AlierenSafi/Aquarium-Controller/images/List.PNG

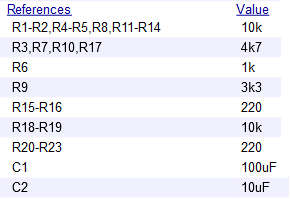
images/List.PNG
