AlierenSafi/Aquarium-Controller/Aquarium_Scheme.PDF

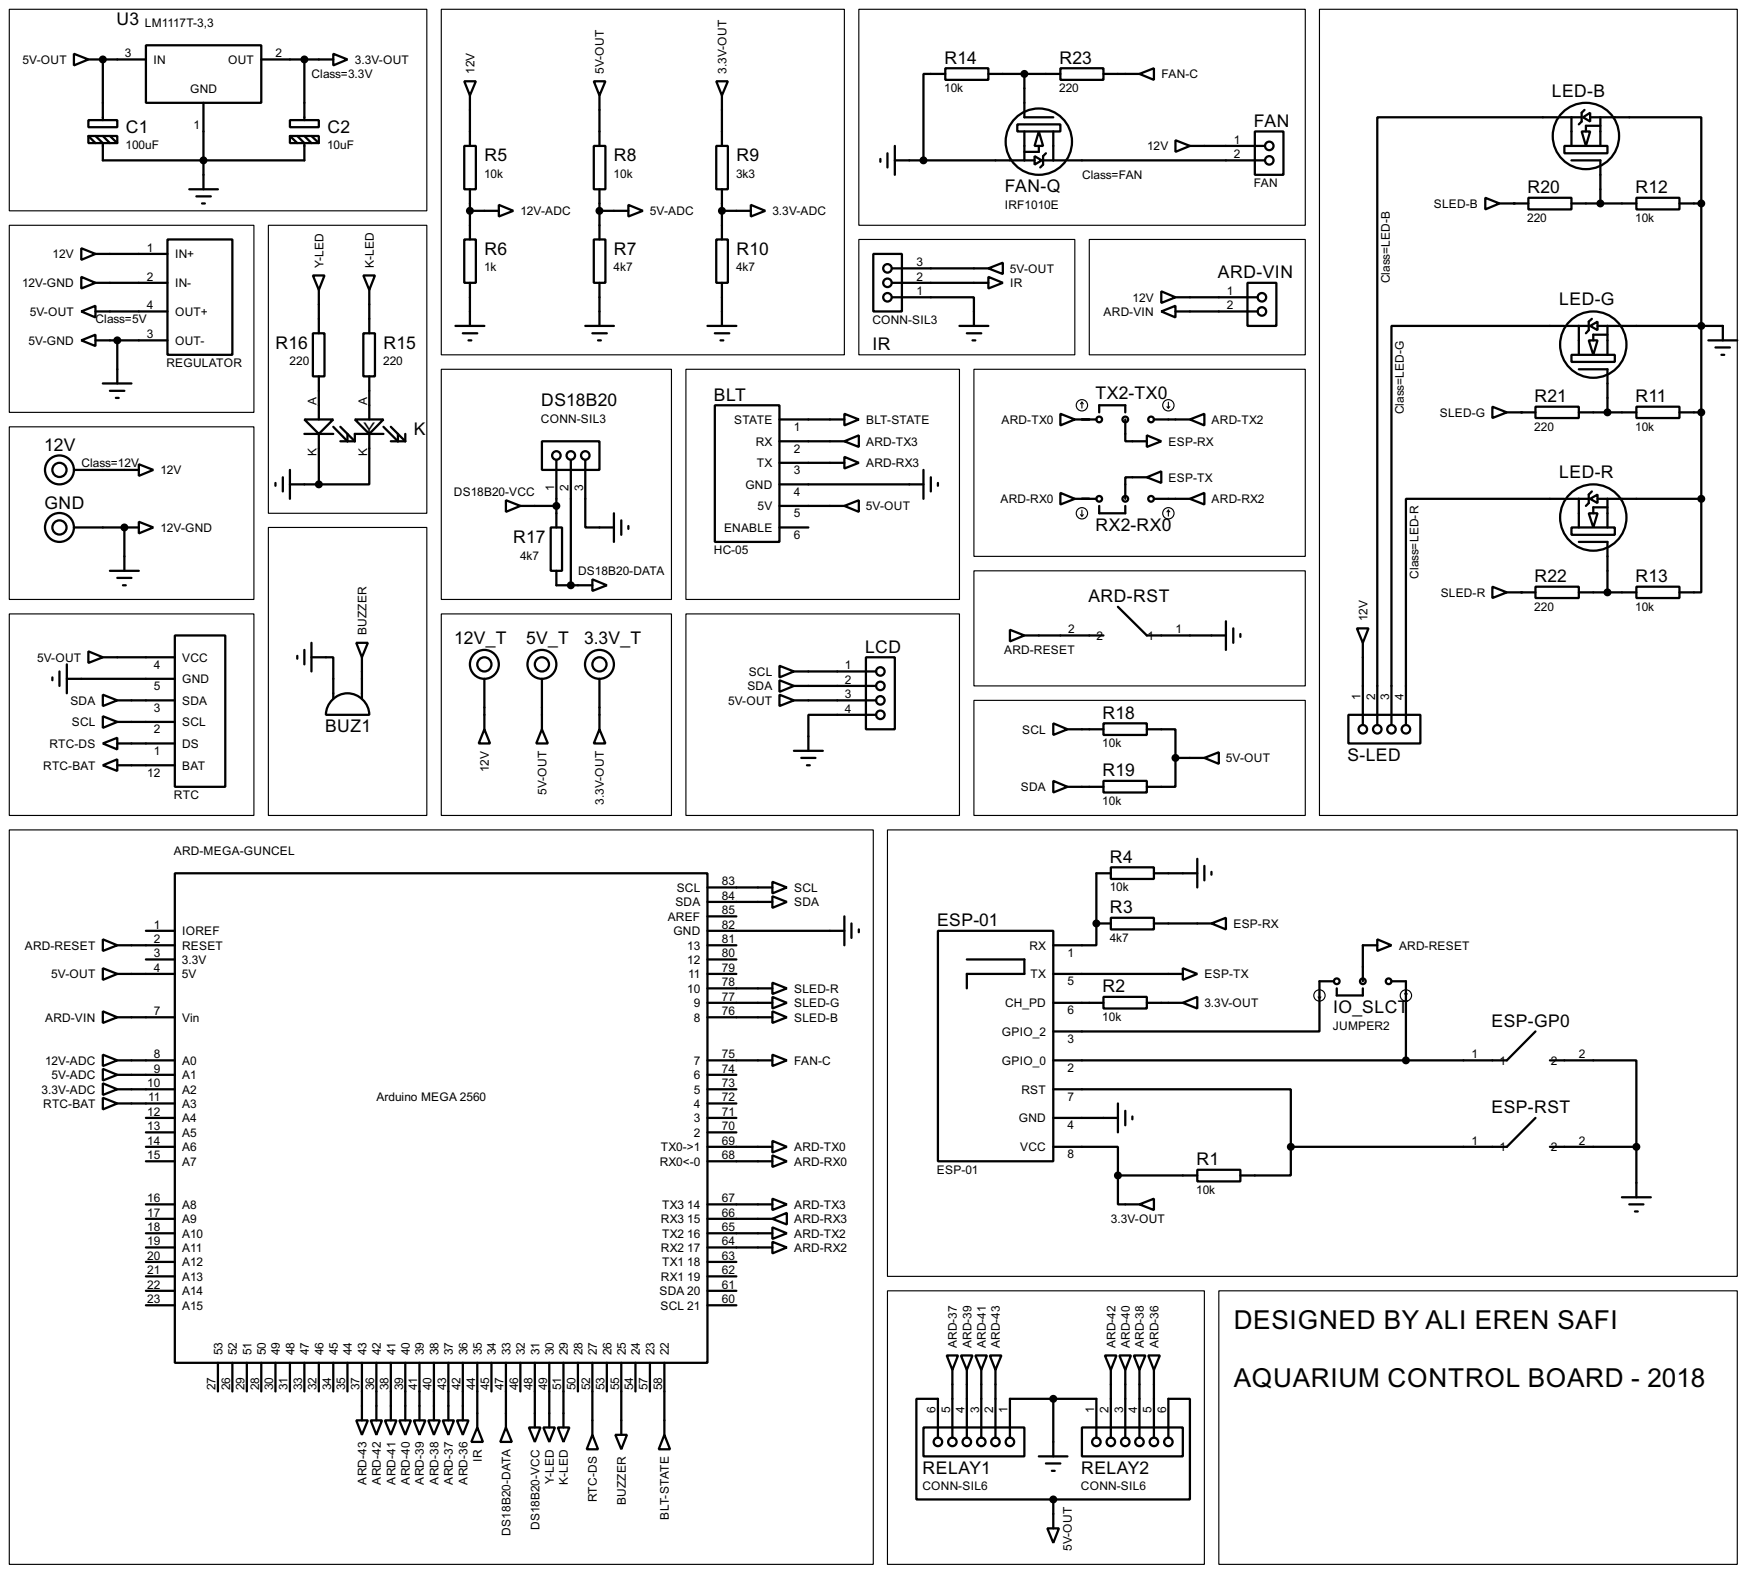
[picture p8: page 1]

Class=LED-B Class=LED-G

SCL RTC-DS RTC-BAT

ARD-43 ARD-41 ARD-39 ARD-37

ARD-36 ARD-38 ARD-40 ARD-42

DESIGNED BY ALI EREN SAFI

ARD-36 ARD-37 ARD-38 ARD-39 ARD-40 ARD-41 ARD-42 ARD-43
