AlierenSafi/Aquarium-Controller/(notices)

Notices in the files:
README.md:
License: MIT
